tateyama77jp/torabo-tsuki-lp/img/v2-box-aa.jpg

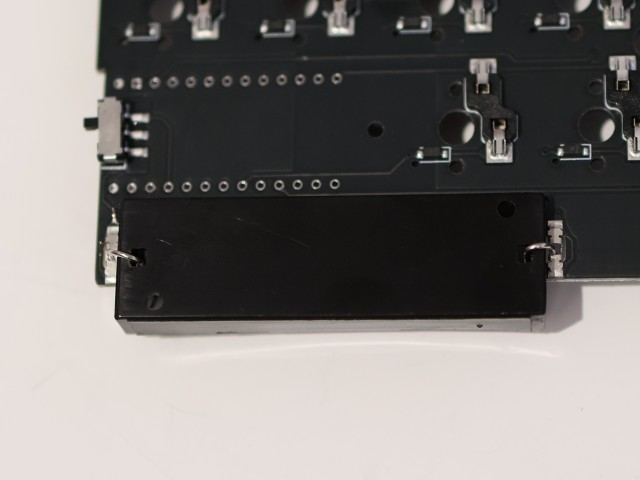
img/v2-box-aa.jpg
