tateyama77jp/torabo-tsuki-lp/3d-models/FreeCAD/controller-cover-aa.FCStd

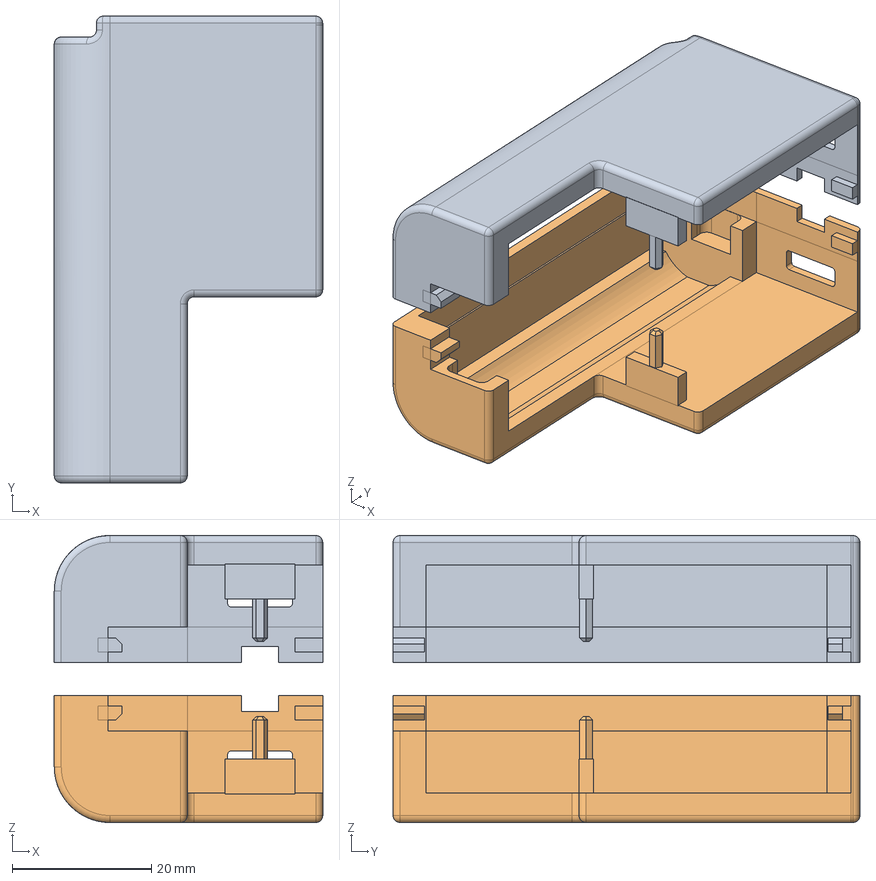
[picture p2: CAD file, 2026-06-15]
3d-models/FreeCAD/controller-cover-aa.FCStd
38.5 x 67.0 x 41.2 mm
Body (Mirror #1)
