tateyama77jp/torabo-tsuki-lp/3d-models/STL/controller-cover-aa-Body-mirror.stl

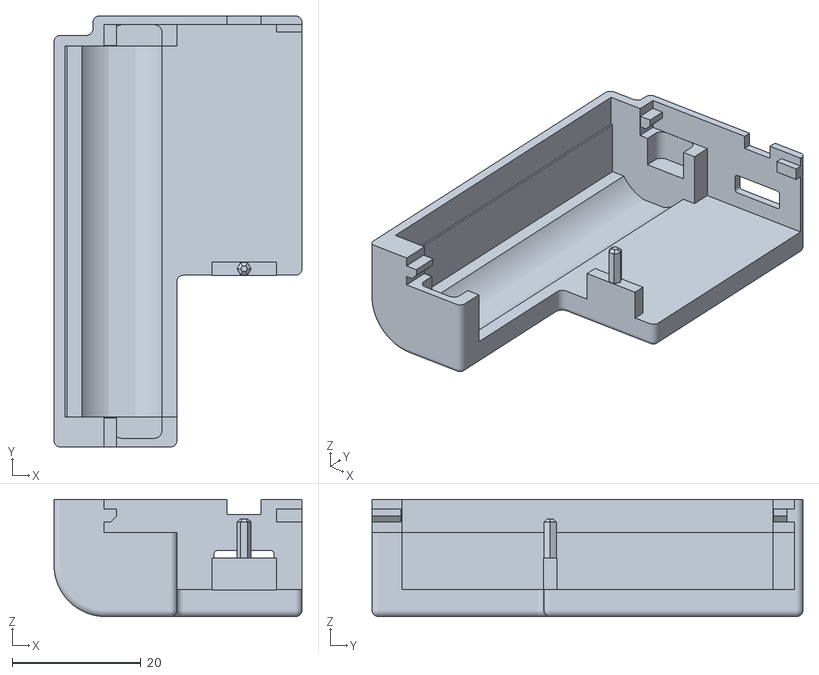
[picture p3: CAD file, 2026-06-15]
3d-models/STL/controller-cover-aa-Body-mirror.stl
38.5 x 67.0 x 18.2
