tateyama77jp/torabo-tsuki-lp/3d-models/STL/option/mini-trackpad/controller-cover-aa-trackpad-Body.stl

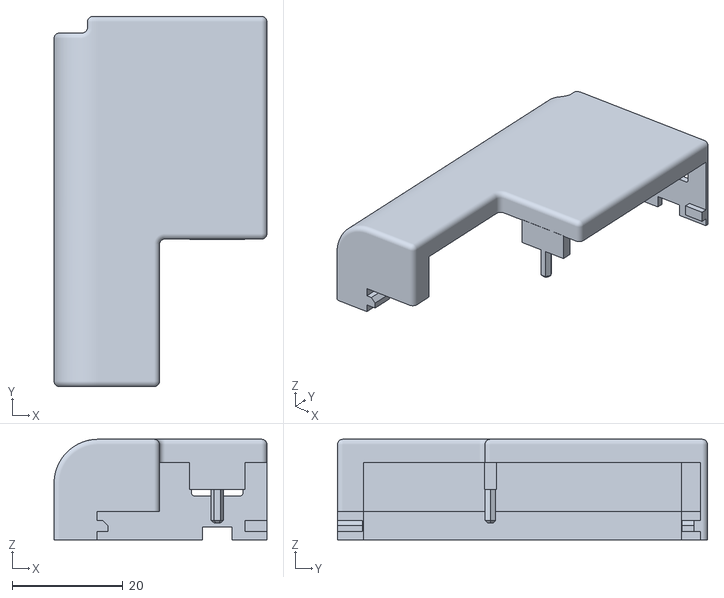
[picture p4: CAD file, 2026-06-15]
3d-models/STL/option/mini-trackpad/controller-cover-aa-trackpad-Body.stl
38.5 x 67.0 x 18.2
