tateyama77jp/torabo-tsuki-lp/3d-models/FreeCAD/controller-cover-aaa-xs.FCStd

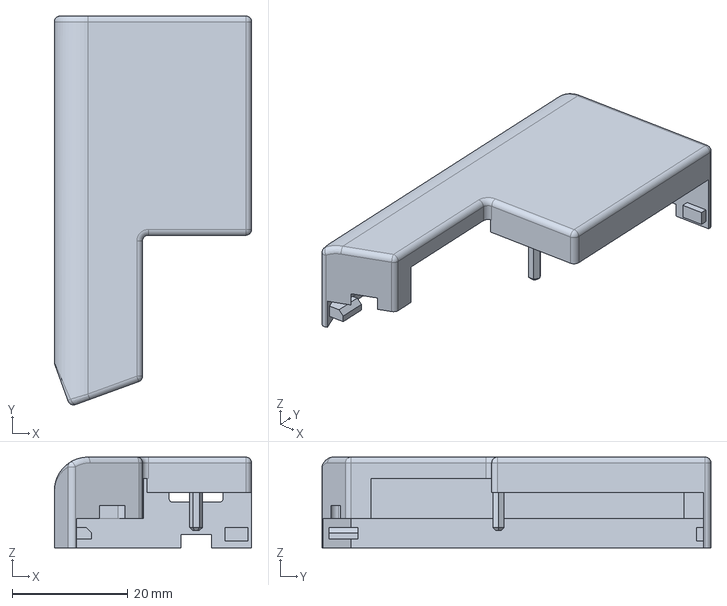
[picture p5: CAD file, 2026-06-07]
3d-models/FreeCAD/controller-cover-aaa-xs.FCStd
34.1 x 67.2 x 15.7 mm
