tateyama77jp/torabo-tsuki-lp/3d-models/FreeCAD/option/controller-cover-aaa-trackpad-xs.FCStd

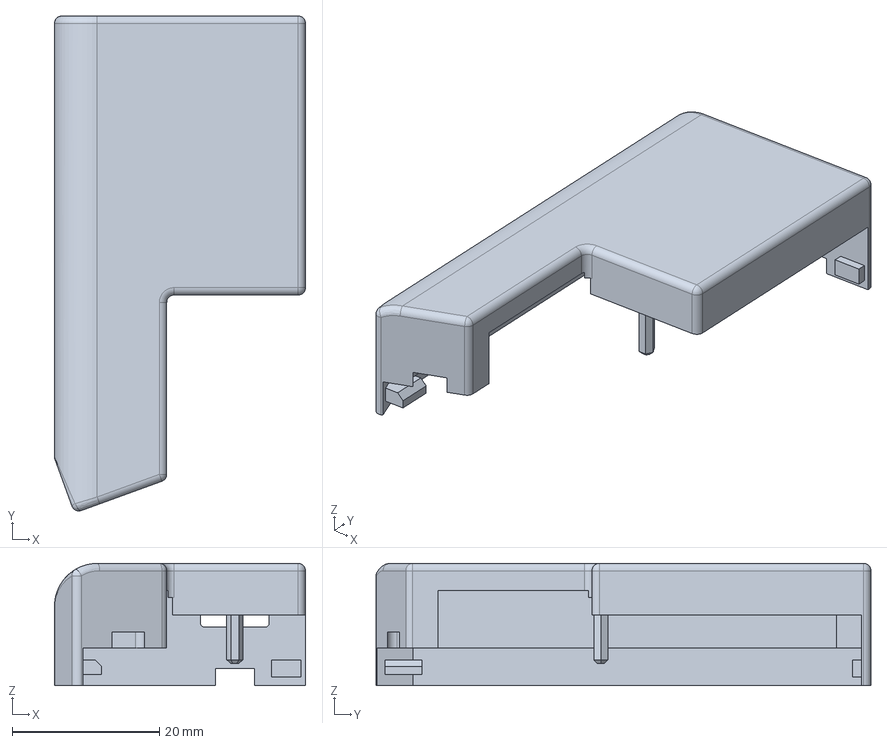
[picture p6: CAD file, 2026-06-07]
3d-models/FreeCAD/option/controller-cover-aaa-trackpad-xs.FCStd
34.1 x 67.2 x 16.6 mm
