tateyama77jp/torabo-tsuki-lp/(list of files, cad)

Other CAD files:
3d-models/FreeCAD/option/controller-cover-aa-trackpad.FCStd
3d-models/STL/controller-cover-aa-Body.stl
3d-models/STL/option/mini-trackpad/controller-cover-aa-trackpad-Body-mirror.stl
3d-models/STL/controller-cover-aaa-xs-Body-mirror.stl
3d-models/STL/option/mini-trackpad/controller-cover-aaa-trackpad-xs-Body-mirror.stl
3d-models/STL/controller-cover-aaa-xs-Body.stl
3d-models/STL/option/mini-trackpad/controller-cover-aaa-trackpad-xs-Body.stl
