tateyama77jp/torabo-tsuki-lp/build-guide.md

# ビルドガイド

torabo-tsuki LPシリーズのビルドガイドです。V1とV2では電池ボックスの取り付け周りの手順が異なります。
自分が組み立てるのはどちらかを確認してから手順を進めてください。

## 同梱品

| 名称 | 数  |
| --- | --- |
| メイン基板 | 1 |
| トッププレート | 2 |
| ボトムプレート | 2 |
| 電池ボックス(単三 or 単四) | 2 |
| スペーサー(4.5mm) | 8 |
| ねじ(M2x3.5) | 18  |
| **トラックボール部品** | |
| トラックボールセンサー(14mmマウスセンサーモジュール) | 1 |
| フレキシブルケーブル(0.5mmピッチ、6P、100mm、電極同一面) | 1 |
| ベアリング(4x1.5x2 mm) | 3 |
| ねじ(M1.4) | 3 |
| **BMP Boost同梱の場合** | |
| BMP Boost | 2 |

## 別途必要な部品

| 名称 | 数 | 補足 |
| --- | ----- | --- |
| キースイッチ(Choc V2) | 42(S, XS), 50(M), 64(L) | |
| キーキャップ | 適量  | |
| 25mmトラックボール交換球  or 19.05mm POMボール | 1 | |
| コンスルー | 4 | 13ピン（高さ2.5mm）を使用してください。欠品している場合は12ピンを5個買って、1個を切り離して使ってください |
| 電池カバー、トラックボールケース(25mm or 19mm) | 1式 | 3Dプリントサービスや自前で出力してください。JLC3DPだと送料込みで$5くらいで製造できます（詳細は後述） |
| ゴム足 | 8 | GRIPLUSなど薄型の物がおすすめです |
| 乾電池 | 2 | S,M,Lは単三、XSは単四、Ni-MH可。USBで充電できるリチウム電池内蔵のものを使う場合、必ずキーボードから取り外してから充電してください |
| **オプション** |||
|ケース| 1式 | [シンプルケース](3d-models/STL/option)や有志が公開・販売しているデータを装着できます |
| **BMP Boost別売りの場合** | | |
| BMP Boost | 2 | BLE Micro Pro (無印)は使用できません。入手先:[BOOTH](https://booth.pm/ja/items/1177319), [遊舎工房](https://shop.yushakobo.jp/products/10737) |

## 必要な工具
- はんだごて、はんだ
- ニッパー
- ペンチ
- ドライバー
- （やすり）
- PC
- USBケーブル

## 3Dプリント部品の製造(JLC3DP利用)

[JLC3DP](https://jlc3dp.com/jp/3d-printing-quote)にアクセスします。

[3d-models/STL](3d-models/STL/)フォルダのSTLファイルの中身をJLC3DPにアップロードします。トラックボールケースはサイズが2種類あります。製造時に片方に決めてもいいですし、両方頼んで届いてから考えてもいいです。

電池カバーは、S,M,Lの場合はaaを、XSの場合はaaaを使用してください。V2ではV1から形状が若干変わっています。過去にV1を組み立て済みで、今回V2を組み立てる方は、改めてデータをダウンロードしてください。

また、[シンプルケース](3d-models/STL/option)、[テンティングケース](https://github.com/sekigon-gonnoc/torabo-tsuki-lp-tenting-case)や、有志が公開・販売しているデータを一緒に製造することもできます。ご自分でデザインしたい場合は[シンプルケースのCADデータ](3d-models/FreeCAD/option/torabo-tsuki-lp-simple-case.FCStd)をご活用ください。



電池カバー、トラックボールケースについての商品概要は`Enclosure..`から`Plastic Enclosure`を選択します。
ケースについては`Office Appliance...`から`Plastic Keyboard Enclosure`を選択してください。



モデルのサムネイルの下に`印刷リスク`の表示がある場合は`はい`をチェックしてください。



カートに保存し、注文手続きを進めます。配送方法はOCSを選択すると2ドルで配送してもらえます（2025年7月時点、月3回まで）。

発注履歴が表示されるようになった状態で数分経ってからタブをリロードすると、ファイル名の横に!マークが表示されることがあります。

その場合は!マークをクリックし、`はい`を選択してください。

|  |  |
| --- | --- |

JLC3DPによるレビュー中にメールで問い合わせが来る場合がありますが、そのまま製造するように依頼してください。
気になる人は自分でCADデータを修正してください。

## 組立手順

### メイン基板のレール部分を折って切り離す



### メイン基板・トッププレートのトラックボール搭載部分と、トラックボールを搭載しないほうのボトム基板の余剰部分を切り離す

シンプルケースを装着する場合は、ボトムプレートは両側とも余剰部分を切り離します。

ニッパーでそのまま切り離せない場合は、表裏に切れ目を入れてから折り取ることもできますが、ほかの配線を傷つけないように注意してください。

> [!caution]
> 向きを間違えないように注意してください。下記画像は右側にトラックボールを搭載する例です。



### (V1の場合)電池ボックスをはんだ付けする

* 電池ボックスの足を折り曲げます。
  * XSに単四電池ケースを取り付ける場合は基板上のマークよりすこし上に寄せてください。基板の穴はBMP Boost側を使います。マイナス極が上側です。
* ボトムプレートに電池ボックスを載せ、その上からメイン基板を載せます。向きに注意してください。
* 余った足を短く切ってからはんだ付けします。メイン基板とボトム基板がぴったりくっついた状態ではんだ付けするようにしてください。

|||
|-|-|
|||

||
|-|
|単四電池ケースの取り付け位置|

### (V2の場合)電池ボックスを基板に差し込む

torabo-tsuki LP V2では電池ボックスもソケットに差し込むだけで取り付けられます。
ソケットの位置に合わせて電池ボックスの足を折り曲げてから差し込みます。
S,M,Lではパーツ配置の都合で斜め方向に足を曲げ、XSでは真上に曲げてください。

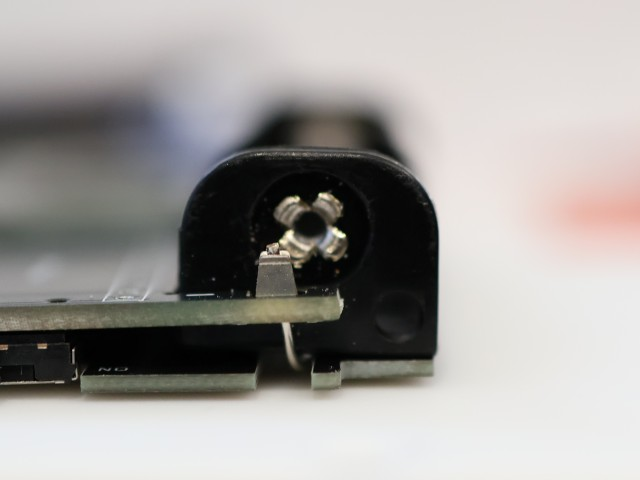
[picture p7: img/v2-aa-side.jpg]
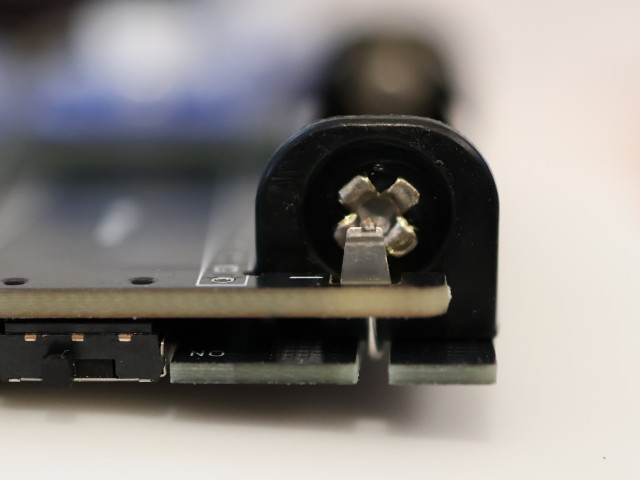
[picture p8: img/v2-aaa-side.jpg]
|||
|-|-|
|S,M,L|XS|

* 電池ボックスのピンを折り曲げます。横から見たときピンが真上に向くように折り曲げていきます。手で90度まで曲げても手を離すと手前まで戻ってしまうので、以下のような手順で進めてください。
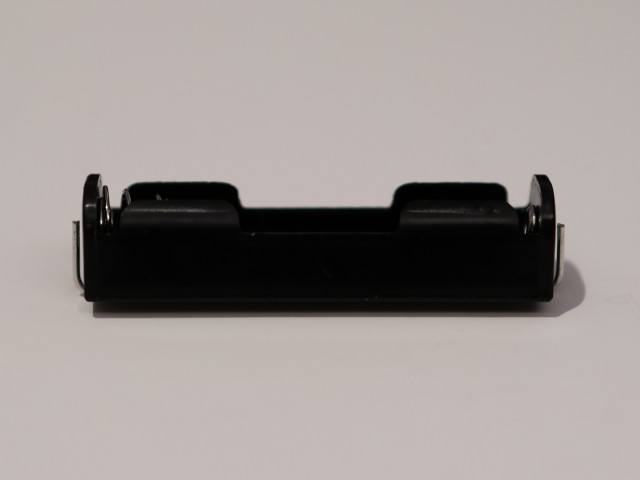
[picture p9: img/v2-box-pin.jpg]
  
  1. 電池ボックスのピン先端をつかみ、真横を向くように曲げます。手を離すと下に少し戻るので、様子を見ながら少しずつ曲げ量を増やします。S,M,Lではパーツの配置の都合上、下から見たとき少し斜めになるようにしてください。XSは真っすぐで大丈夫です。

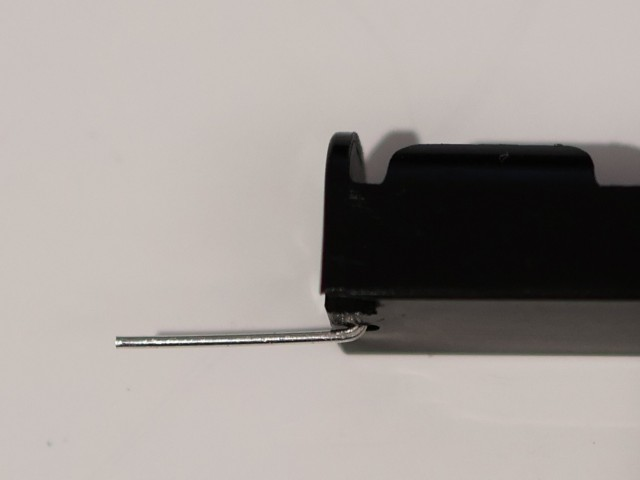
[picture p10: img/v2-box-step1.jpg]
      ||
      |-|
      |横から見たとき|
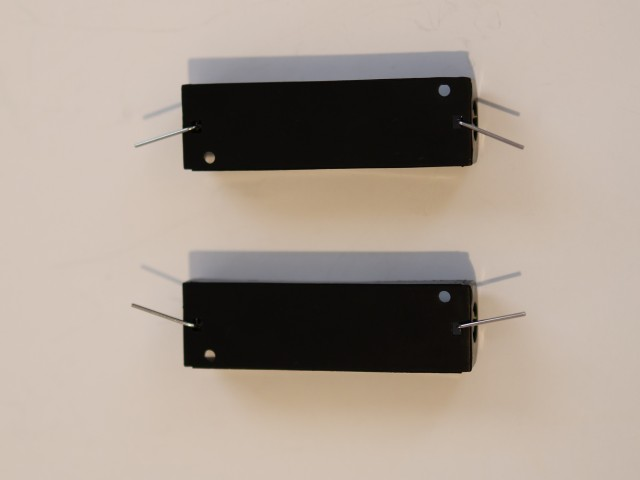
[picture p11: img/v2-box-aa-step1.jpg]
      ||
      |S,M,L|
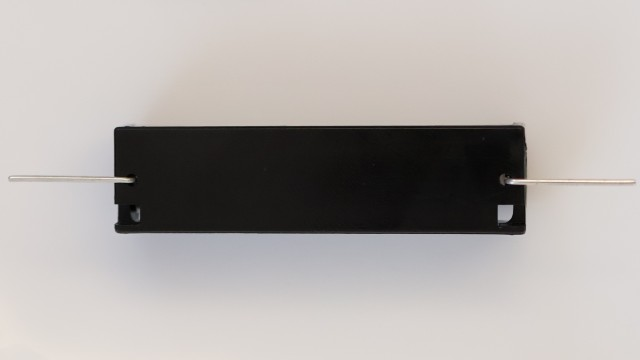
[picture p12: img/v2-box-step1.1.jpg]
      ||
      |XS|

  2. ボトムプレートを間に挟みながらもう90度曲げます。手を離すと90度より手前に戻りますが、そのまま次に進みます。

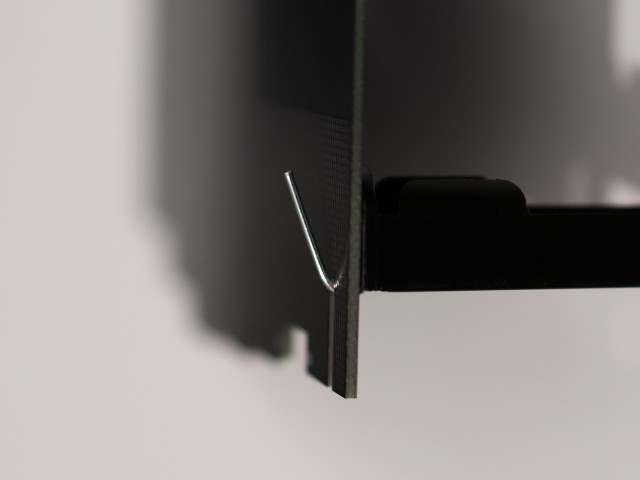
[picture p13: img/v2-box-step2.jpg]
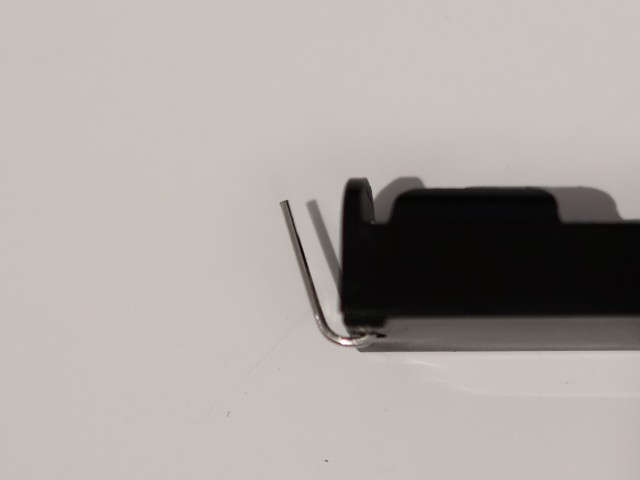
[picture p14: img/v2-box-step3.jpg]
      |||
      |-|-|

  3. 電池ボックスのピン先端をつかんでさらに曲げます。電池ボックスと干渉するので、このステップでも90度までは曲がりません。

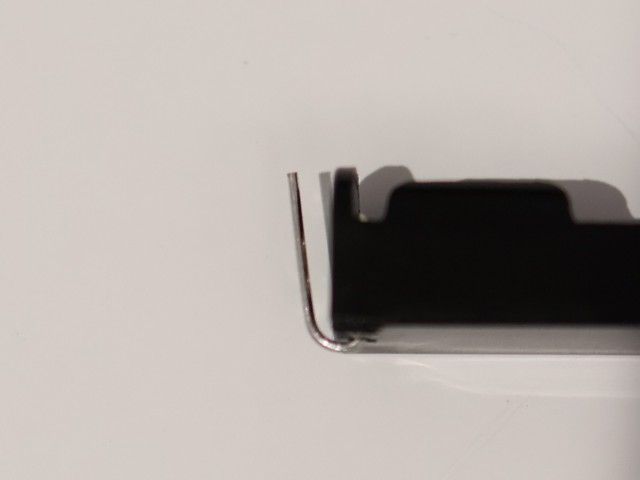
[picture p15: img/v2-box-step4.jpg]
      

  4. 電池ボックスの横に空いている穴の上端のところで、電池ボックスのピンをニッパーでカットします。

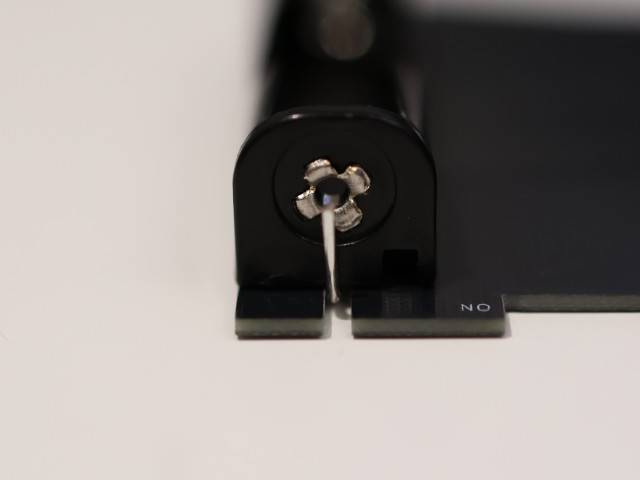
[picture p16: img/v2-box-step5.jpg]
      

  5. ピンの先端を電池ボックスの横の穴に押し込むように曲げます。手を離したときにピンが真上を向くところまで曲げてください。

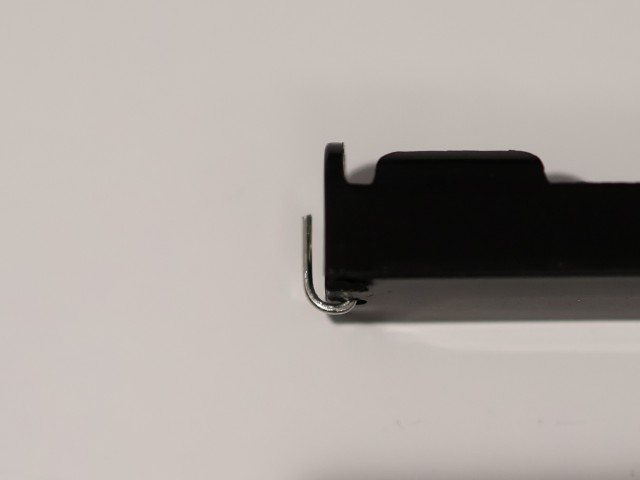
[picture p17: img/v2-box-step6.jpg]
      

* 電池ボックスをメイン基板に差し込む
  * 電池ボックスのピンが、基板の板バネでしっかり挟みこまれていることを確認してください

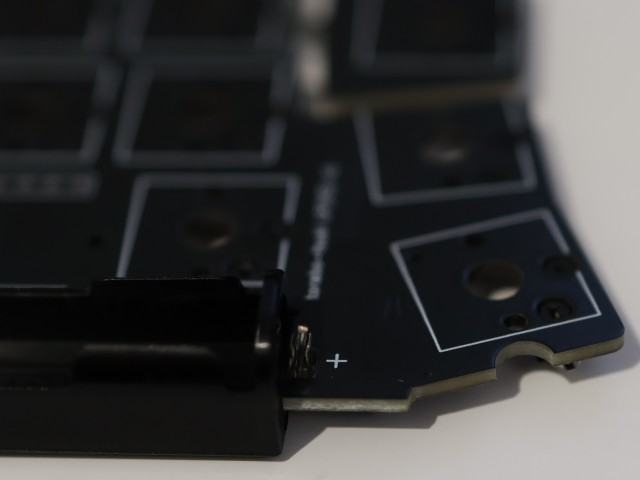
[picture p18: img/v2-box-plus.jpg]
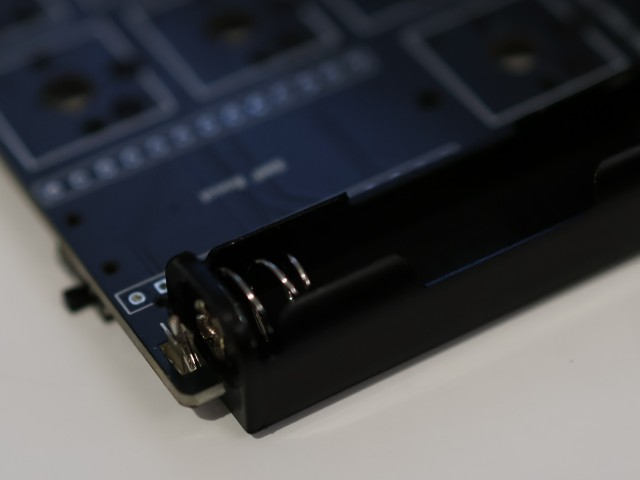
[picture p19: img/v2-box-minus.jpg]
|||
|-|-|

### トッププレート・メイン基板にスイッチを差し込む



### メイン基板にBMP Boostをコンスルーで取り付ける

* はんだ付けは不要です。
* コンスルーの向きは揃えてください。

|||
|-|-|

### ファームウェアを書きこむ

* スイッチをOFFにした状態で、BMPをPCにUSBケーブルで接続します。
* BLEMICROPROという名前のストレージがマウントされたら、中身にINFO_UF2.TXTがあることを確認してください。
* [Releases](https://github.com/sekigon-gonnoc/zmk-keyboard-torabo-tsuki-lp/releases)からファームウェアのuf2ファイルをダウンロードします。
* uf2ファイルを1つ選んでストレージにコピーしてください。トラックボールがあるほうがCentral、ないほうがPeripheralです。
  * たとえば右側トラックボールで組み立てた場合、右手に`torabo_tsuki_lp_right_central`、左手に`torabo_tsuki_lp_left_peripheral`を書き込んでください。
* 書き込みが完了したら一度USBケーブルを抜き、スイッチをONにした状態でUSBケーブルを差し直すとキーボードとして動作します。

### トッププレートにスペーサーをねじ止めする

* スペーサーをトッププレートにねじ止めします。



### トラックボールケースにベアリングをネジで固定する

* ケースに空いている穴にねじを押し込みながら回すようにしてベアリングを固定します。
* ベアリングは多少ガタつきますが問題ありません。



### トラックボールセンサーにケーブルを差し込む

* コネクタのフラップ（黒い部分）を上に持ち上げ、トラックボールのケーブルをしっかり奥まで差し込み、フラップを下げます。
  * [コネクタの操作方法と注意点をよく確認してください](https://www.hirose.com/ja/product/document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)



### トラックボールのケーブルをメイン基板のコネクタに差し込む



### センサーの動作確認をする

* USBケーブルでPCとBMP Boostを接続します。
* センサーのレンズ側を机から2mmくらい浮かせてセンサー基板を動かしたり、レンズの上空を指で動かしたりしてマウスカーソルが動くならば、センサーは正常に動作しています。 
* センサーの動作確認ができたらUSBケーブルは取り外してください。

### トラックボールセンサーをケースに取り付ける

* ケースの中央あたりまで差し込みます。
* 緩すぎてすぐ抜けてしまう場合は紙などを挟んで調節してください。
* きつすぎる場合は背面の突起を削ってください。
* トラックボールの反応が悪い場合には取り付け位置を調整してください。

|||
|-|-|

### ボトムプレートを取り付け、ボトムプレートにトラックボールケースを取り付ける

* シンプルケースを装着する場合はケースも一緒にねじ止めしてください。



### (V2の場合)電池ボックスの余った足をカットする

* 電池ボックスをボトムプレートに接地するように下側に寄せて、余った足をニッパーでカットしてください。
  * 電池ボックスがボトムプレートから浮いた状態でカットしてしまうと、使用中に電池ボックスが下側に抜けてしまう可能性があるので、注意してください。

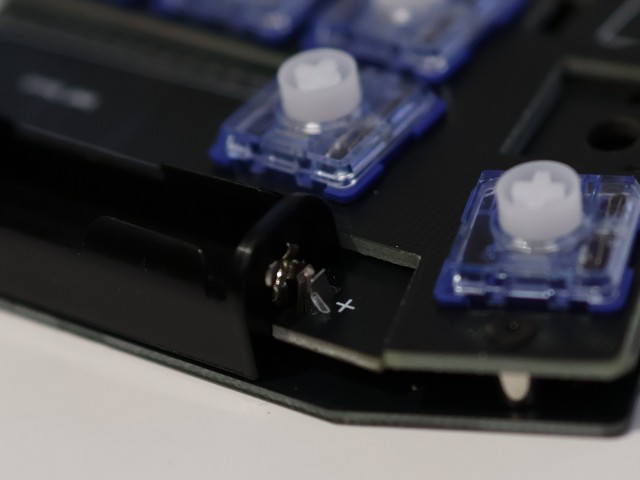
[picture p20: img/v2-box-plus-cut.jpg]
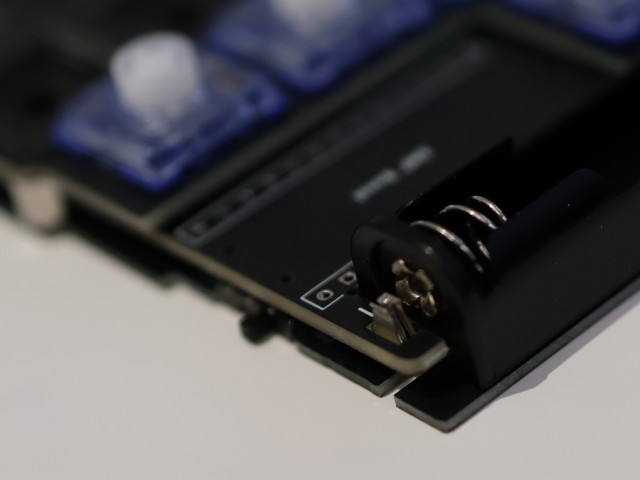
[picture p21: img/v2-box-minus-cut.jpg]
|||
|-|-|

### トラックボールケースにボールを入れる

* ボールをケースに押し込んで入れます。

### 電池を入れる

* 電池をケースに入れます。向きに注意してください。

### 電池カバーを付ける

* 外側の爪2箇所(XSは1箇所)をメイン基板にひっかけます。
* 内側の爪（USBコネクタ横の爪）を引っ張りながらメイン基板にひっかけます。

||||
|-|-|-|

> [!caution]
> V2基板に対してV1用のカバーを無理やり取り付けようとした場合、電池ボックス用のソケットが破損します。
> V2用カバーを取り付ける場合も基板側面にカバーを確実に押し当てなが内側の爪をひっかけるようにしてください。
>
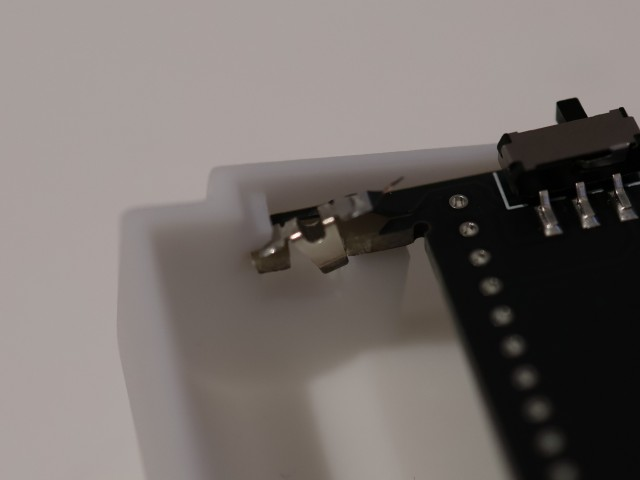
[picture p22: img/v2-battery-caution.jpg]
> 

* ボトムプレートを外した場合、下の図で赤く示した4箇所で固定されています



### ゴム足を付ける



### キーキャップを取り付ける

**以上で組立は完了です、お疲れさまでした。**

## 使い方

### 電源の説明

* スライドスイッチをON側に切り替えると電源が入ります。電源がONするとLEDが点滅します。
* 有線接続する場合でもスライドスイッチはON側にしてからケーブルを接続してください。OFFの状態で接続した場合はブートローダが起動します。

### LEDの説明

親指のところに赤色LEDがついています。

* 起動時：点滅回数(1~3)でバッテリー残量を示しています
* ペアリング中：ペアリング先を探している間、数秒に1回点灯します。ペアリングが完了すると1回点灯します。



### 無線接続

* 両手のスライドスイッチをONして、接続先のデバイスでペアリングします。

### キーマップを変更する

* [ZMK Studio](https://zmk.studio/)または[Keymap-Editor](https://nickcoutsos.github.io/keymap-editor/)でキーマップが変更できます。
* Keymap-Editorを使用する場合は[zmk-keyboard-torabo-tsuki-lp](https://github.com/sekigon-gonnoc/zmk-keyboard-torabo-tsuki-lp)をクローンして編集してください。
  * Keymap-Editorの仕様によりconfig/info.jsonはLサイズ用になっているため、S,Mサイズには存在しないキーも表示されます。
  * [ファームウェアの書き込み方](#ファームウェアを書きこむ)を参考にして、新しく作ったuf2ファイルを書き込んでください。

## トラブルと対策

* 初期不良による部品交換が必要な場合や、組立ミスのため一部部品だけ購入したい場合はBOOTHからメッセージをお送りください。
* 組立にあたってのトラブルで相談がある場合は本リポジトリのissueに投稿してください。
  * **投稿の前に既存のissueを検索してください**

## FAQ

まずはZMKのドキュメントを確認してください。

### ペリフェラル側をUSB接続してもキー入力できない

* ZMKの仕様です
* セントラルとペアリングしたうえでセントラル側を有線または無線接続してください

### 無線接続に問題がある

* 電源が入っているか確認してください。
* ZMKのドキュメントを確認してください。
* settings_resetのファームウェアを書き込む場合、uf2を書き込むだけでなく、一度再起動が必要です
  * スイッチOFF→USB接続→書き込み→USB外す→スイッチON→USB再接続でsettings_resetのファームウェアが動作して、設定が初期化されます

### トラックボールの動きだしが遅い

* 一定時間ボールを動かさなかった場合にセンサーがスリープ状態になります。スリープ状態の解除に少し時間がかかるため動き出しが遅くなる場合があります。

### トラックボールの動きがおかしい/動かない

* [センサーの位置調整](#トラックボールセンサーをケースに取り付ける)をご確認ください。
* トラックボールのケーブルがコネクタにしっかりささっているか確認してください。
* センサーの仕様として、最大速度24inch/s、最大加速度10Gという制約があります。25mmボールの回転速度に換算すると9回転/sが最大速度で、これを超える速度で回転させた場合にはカーソルが逆方向に動くことがあります。

### 一部のキーが入力できない

* スイッチの足が折れ曲がっていないか、BMP Boostが浮いていないか確認してください。

### トラックボールの移動速度を変えたい/オートマウスレイヤー/スクロールレイヤーを使用したい

* ZMKのinput processorを使用してください。
