tateyama77jp/torabo-tsuki-lp/(commit log)

2026-06-06 XSシンプルケースの反転したSTLを追加
2026-06-07 v2の情報を追加
    [controller-cover-aaa-trackpad-xs-Body-mirror.stl, controller-cover-aaa-trackpad-xs-Body.stl, controller-cover-aaa-trackpad-xs.FCStd, controller-cover-aaa-xs-Body-mirror.stl, controller-cover-aaa-xs-Body.stl, controller-cover-aaa-xs.FCStd]
2026-06-07 電池ボックスの曲げ手順を詳細化
2026-06-14 S,M,Lサイズ用のV2組み立て手順を追加
2026-06-15 V2用データを公開
    [controller-cover-aa-Body-mirror.stl, controller-cover-aa-Body.stl, controller-cover-aa-trackpad-Body-mirror.stl, controller-cover-aa-trackpad-Body.stl, controller-cover-aa-trackpad.FCStd, controller-cover-aa.FCStd]
